Haichao-Z/doufu.github.io/PCBA/Good Night-(src,fab,asm)/ASM-Good Night-[NO VARIATIONS]-A.5/BOM/Bill of Materials-BillOfMaterials.xlsx

Name | Description | Designator | Footprint | LibRef | Quantity | Supplier Unit Price 1 | Supplier Subtotal 1 | Supplier Part Number 1 | Supplier 1 | Manufacturer Part Number 1 | Manufacturer Lifecycle 1 | Manufacturer 1 | Line #
CAP 0805 4.7UF 50V 10% X5R | Capacitor Surface Mount 0805 Footprint 4.7UF 50V 10% Tolerance Ceramic X5R | C1, C7, C9 | 0805_CAP | CMP-001-00021-2 | 3 | 0.35 | 1.05 | 311-1885-1-ND | Digikey | CC0805KKX7R8BB475 | Volume Production | Yageo
CAP 0603 0.01UF 50V 10% X7R | Capacitor Surface Mount 0603 Footprint 0.01UF 50V 10% Tolerance Ceramic X7R | C2 | 0603_CAP | CMP-011-000188-2 | 1 | 0.1 | 0.1 | 311-1085-6-ND | Digikey | CC0603KRX7R9BB103 | Volume Production | Yageo
CAP 0805 4.7UF 10V 10% X7R | Capacitor Surface Mount 0805 Footprint 4.7UF 10V 10% Tolerance Ceramic X7R | C3 | 0805_CAP | CMP-011-000522-1 | 1 | 0.35 | 0.35 | 311-1883-1-ND | Digikey | CC0805KKX7R7BB475 | Volume Production | Yageo
CAP 0603 0.1UF 50V 10% X7R | Capacitor Surface Mount 0603 Footprint 0.1UF 50V 10% Tolerance Ceramic X7R 100nF | C4, C5, C6, C32 | 0603_CAP | CMP-011-000223-3 | 4 | 0.024 | 0.24 | 311-1344-1-ND | Digikey | CC0603KRX7R9BB104 | Volume Production | Yageo
CAP 0603 1UF 50V 10% X7R | Capacitor Surface Mount 0603 Footprint 1UF 50V 10% Tolerance Ceramic X7R | C8, C11, C12, C28, C30, C34 | 0603_CAP | CMP-011-000287-2 | 6 | 0.052 | 0.52 | 311-1445-1-ND | Digikey | CC0603KRX5R8BB105 | Volume Production | Yageo
CAP 1206 10UF 50V 10% X5R | Capacitor Surface Mount 1206 Footprint 10UF 25V 10% Tolerance Ceramic X5R | C10, C13 | 1206_CAP | CMP-001-00003-5 | 2 | 0.15 | 0.3 | 311-1817-1-ND | Digikey | CC0603MRX5R6BB106 | Volume Production | Yageo
CAP 0603 18PF 50V 5% C0G | Capacitor Surface Mount 0603 Footprint 18PF 50V 5% Tolerance Ceramic C0G | C14, C15 | 0603_CAP | CMP-011-000283-1 | 2 | 0.1 | 0.2 | 311-1061-6-ND | Digikey | CC0603JRNPO9BN180 | Volume Production | Yageo
CAP 0603 10UF 16V 20% X5R | Capacitor Surface Mount 0603 Footprint 10UF 16V 20% Tolerance Ceramic X5R | C16, C26, C29 | 0603_CAP | CMP-011-000263-1 | 3 | 0.15 | 0.45 | 311-1817-1-ND | Digikey | CC0603MRX5R6BB106 | Volume Production | Yageo
C0805C476M9PACTU | CAP CER 47UF 6.3V X5R 0805 | C17, C24, C25 | FP-C0805C476M9PACTU-MFG | CMP-2007-01008-2 | 3 | 0.36 | 1.08 | 311-1897-1-ND | Digikey | CC0805MKX5R5BB476 | Volume Production | Yageo
CC0603KRX7R7BB104 | CAP CER 0.1UF 16V X7R 0603 | C18, C35, C37 | FP-CC0603-DA-MFG | CMP-2000-05002-2 | 3 | 0.1 | 0.3 | 13-CC0603KPX7R9BB101CT-ND | Digikey | CC0603KPX7R9BB101 | Volume Production | Yageo
CGA3E2X7R1H104K080AA | Cap Ceramic 100nF 50V X7R 10% Pad SMD 0603 +125°C Automotive T/R | C19 | FP-CGA3E-0_3-0_1-IPC_A | CMP-2000-07546-2 | 1 | 0.08 | 0.08 | 311-1088-6-ND | Digikey | CC0603KRX7R7BB104 | Volume Production | Yageo
C0603C105K3RACTU |  | C20 | CAPC1608X87X35LL15T15 | CMP-2006-03713-1 | 1 | 0.11 | 0.11 | 311-1456-1-ND | Digikey | CC0805KKX7R8BB105 | Volume Production | Yageo
C0805C822J2GACAUTO | CAP CER 8200PF 200V C0G/NP0 0805 | C21 | FP-C0805C-DN-MFG | CMP-2007-03316-2 | 1 | 0.1 | 0.1 | 311-4024-1-ND | Digikey | CC0603JRX7R9BB822 | Volume Production | Yageo
C0603C430J5GACTU | CAP CER 43PF 50V 5% NP0 0603 | C22 | FP-C0603C-CF-MFG | CMP-1035-01031-3 | 1 | 0.16 | 0.16 | 13-CC0603FRNPO9BN430CT-ND | Digikey | CC0603FRNPO9BN430 | Unknown | Yageo
06035C102KAT2A | General Purpose Ceramic Capacitor, 0603, 1nF, 10%, X7R, 15%, 50V | C23 | FP-0603-L_1_6_0_15-W_0_81-IPC_A | CMP-2006-04378-2 | 1 | 0.1 | 0.1 | 311-1127-1-ND | Digikey | CC0805KRX7R9BB102 | Volume Production | Yageo
CAP 0805 22UF 10V 20% X5R | Capacitor Surface Mount 0805 Footprint 22UF 10V 20% Tolerance Ceramic X5R | C27, C31, C33 | 0805_CAP_60H | CMP-011-000507-1 | 3 | 0.33 | 0.99 | 311-1900-1-ND | Digikey | CC0805MKX5R6BB226 | Volume Production | Yageo
EEUFR1H101 | Aluminum Electrolytic Capacitors (Radial Lead Type) 100uF ±20% 50V | C36, C38 | FP-RAD-TH-D_8_0_5-L_11_5-MFG | CMP-05427-002079-1 | 2 | 0.51 | 1.02 | 667-EEU-FR1H101 | Mouser | EEU-FR1H101 | Volume Production | Panasonic
LSM0805412V | Single Color LED, RED, 0805 | D1, D2 | LED_0805_RED | CMP-00026-00001-2 | 2 | 0.43 | 0.86 | 28-LSM0805412VCT-ND | Digikey | LSM0805412V | Volume Production | Visual Communications
LSM0805452V | Single Color LED, Green, 0805 | D3, D6, D12 | LED_0805 | CMP-00038-4 | 3 | 0.34 | 1.02 | 28-LSM0805452VCT-ND | Digikey | LSM0805452V | Volume Production | Visual Communications
SMBJ5.0CA-TR | TVS DIODE 5V 13.4V SMB | D13 | FP-SMB-CA-MFG | CMP-12225-000020-1 | 1 | 0.47 | 0.47 | 497-3145-1-ND | Digikey | SMBJ5.0CA-TR | Volume Production | STMicroelectronics
LSM0805543V | LED Uni-Color Blue 469nm Automotive 2-Pin Chip 0805(2012Metric) T/R | D14 | LED_0805_WHITE | CMP-00535-1 | 1 | 0.59 | 0.59 | 28-LSM0805543VCT-ND | Digikey | LSM0805543V | Volume Production | Visual Communications
LSM0805463V | LED Uni-Color Blue 469nm Automotive 2-Pin Chip 0805(2012Metric) T/R | D15 | LED_0805_BLUE | CMP-00457-1 | 1 | 0.43 | 0.43 | 28-LSM0805463VCT-ND | Digikey | LSM0805463V | Volume Production | Visual Communications
LSM0805472V | LED Uni-Color Yellow 590nm Automotive 2-Pin Chip 0805(2012Metric) T/R | D16 | LED_0805_YELLOW | CMP-031-000001-1 | 1 | 0.34 | 0.34 | 28-LSM0805472VCT-ND | Digikey | LSM0805472V | Volume Production | Visual Communications
ECLAMP2410PQTCT | Trans Voltage Suppressor Diode, 5V V(RWM), Bidirectional, 7 Element, Silicon with EMI Filter | DN1 | ECLAMP2410PQTCT-Footprint-1 | CMP-00096-2 | 1 | 2.07 | 2.07 | ECLAMP2410PQTCTCT-ND | Digikey | ECLAMP2410PQTCT | Volume Production | Semtech
MF-NSMF050-2 | PTC RESET FUSE 13.2V 500MA 1206 | F1, F2 | FP-MF-NSMF050-2-MFG | CMP-07400-000036-1 | 2 | 0.19 | 0.38 | MF-NSMF050-2CT-ND | Digikey | MF-NSMF050-2 | Volume Production | Bourns
MPZ2012S601AT000 | 600 Ohms @ 100 MHz 1 Power Line Ferrite Bead 0805 (2012 Metric) 2A 100mOhm | FB1 | FP-MPZ2012-MFG (0805) | CMP-00563-1 | 1 | 0.11 | 0.11 | 445-MPZ2012S601AT000CT-ND | Digikey | MPZ2012S601AT000 | Volume Production | TDK
USBUF02W6 | Terminator, 2-Line, PDSO6; RC (Pi) EMI Filter 2nd Order Low Pass 2 Channel R = 22Ohms, C = 47pF 6-TSSOP, SC-88, SOT-363, USB 1.1 | FL1 | SOT-363-6-ST | CMP-00571-2 | 1 | 0.32 | 0.32 | 497-3743-1-ND | Digikey | USBUF02W6 | Volume Production | STMicroelectronics
693071020811 | WR-CRD Micro SD Card Connector Push & Push | J1 | 693071020811 | CMP-00419-6 | 1 | 3.56 | 3.56 | 732-693071020811CT-ND | Digikey | 693071020811 | Volume Production | Wurth Electronics
ARM Cortex Debug | 10 Pin Shrouded Header, 0.050", Key Pin 7 | J2 | FTSH-105-01-F-DV-007-K PLUGIN | CMP-002-000013-2 | 1 | 2.27 | 2.27 | SAM11250-ND | Digikey | FTSH-105-01-F-DV-007-K-P | Volume Production | Samtec
MHDR 1X2 | Header, 2-Pin, 0.1in Pitch, Male | J4, J5, J6, J7, J8, J9, J10, J11, J12, J13 | PH1-02-UA | CMP-000021-1 | 10
MHDR 1X3 | Header, 3-Pin, 0.1in Pitch, Male | J14, J15 | PH1-03-UA WITH CONNECTOR | CMP-000023-1 | 2
MHDR 1X7 | Header, 7-Pin, 0.1in Pitch, Male | J16 | MHDR 1X7-Footprint-1 | CMP-00373-1 | 1 | 0.1 | 0.1 | 2057-PH1-07-UA-ND | Digikey | PH1-07-UA | Unknown | Adam Equipment
B2B-PH-SM4-TBT(LF)(SN) | Connector Header, PH Series, 2 Position, 2.00mm, 100V, Surface Mount, Solder, Pick and Place, Natural. | J32 | FP-B2B-PH-SM4-TBT_LF_SN-MFG | CMP-00418-1 | 1 | 0.69 | 0.69 | 455-B2B-PH-SM4-TBTDKR-ND | Digikey | B2B-PH-SM4-TBT | Unknown | JST
USB4110-GF-A | USB Connector, 16 Contact(s), Male, Right Angle, Surface Mount Terminal, Locking, Receptacle USB-C (USB TYPE-C) USB 2.0 Receptacle Connector 24 (16+8 Dummy) Position Surface Mount, Right Angle | J33 | FP-USB4110-GF-A-MFG | CMP-00451-3 | 1 | 1.24 | 1.24 | 2073-USB4110-GF-A-6-ND | Digikey | USB4110-GF-A | Volume Production | Global Connector Technology
0603 link | 0O link, SMD, 0603, Solder Bridge Option | JP1, JP2, JP4, JP5, JP9, JP10, JP11, JP12, JP13, JP14 | 0603_JP_RES | CMP-00422-5 | 10 | 0.01 | 0.1 | RMCF0603ZT0R00CT-ND | Digikey | RMCF0603ZT0R00 | Volume Production | Stackpole Electronics
744373360047 | General Purpose Inductor, 0.47uH, 20%, 1 Element, Powdered Iron-Core, SMD, 2220 | L1 | WE-LHMI_5030 | CMP-002-000030-2 | 1 | 2.45 | 2.45 | 732-6160-1-ND | Digikey | 744373360047 | Volume Production | Wurth Electronics
LQW21HN1R0J00L | FIXED IND 1UH 115MA 2.86 OHM SMD | L2 | FP-LQW21HN_00-MFG | CMP-06042-000167-1 | 1 | 0.34 | 0.34 | 490-9679-1-ND | Digikey | LQW21HN1R0J00L | Volume Production | Murata
744311100 | General Purpose Inductor, 1uH, 20%, 1 Element, SMD, 2827 | L3 | WE-HCI_7040 | CMP-002-000018-2 | 1 | 3.42 | 3.42 | 732-4177-1-ND | Digikey | 744311100 | Volume Production | Wurth Electronics
RES 0603 1K 1% | Resistor Surface Mount, 1K Ohms, 0603 Footprint, 1% Tolerance 0.1W | R1, R3, R4, R6, R7 | 0603_RES | CMP-005-002503-3 | 5 | 0.02 | 0.2 | RMCF0603FT1K00CT-ND | Digikey | RMCF0603FT1K00 | Volume Production | Stackpole Electronics
RES 0603 1.13K 1% | Resistor Surface Mount, 1.13K Ohms, 0603 Footprint, 1% Tolerance 0.1W | R2, R5 | 0603_RES | CMP-005-001984-2 | 2 | 0.1 | 0.2 | RMCF0603FT1K13CT-ND | Digikey | RMCF0603FT1K13 | Volume Production | Stackpole Electronics
RES 0603 100 1% | Resistor Surface Mount, 100 Ohms, 0603 Footprint, 1% Tolerance 0.1W | R8, R9, R39 | 0603_RES | CMP-005-002125-2 | 3 | 0.02 | 0.2 | RMCF0603FT100RDKR-ND | Digikey | RMCF0603FT100R | Volume Production | Stackpole Electronics
RES 0603 10K 1% | Resistor Surface Mount, 10K Ohms, 0603 Footprint, 1% Tolerance 0.1W | R10, R11 | 0603_RES | CMP-005-002156-3 | 2 | 0.1 | 0.2 | RMCF0603FT10K0DKR-ND | Digikey | RMCF0603FT10K0 | Volume Production | Stackpole Electronics
RES 0603 12K 5% | Resistor Surface Mount, 12K Ohms, 0603 Footprint, 5% Tolerance 0.1W | R12 | 0603_RES | CMP-005-002260-2 | 1 | 0.1 | 0.1 | RMCF0603FT12K0DKR-ND | Digikey | RMCF0603FT12K0 | Volume Production | Stackpole Electronics
RES 0603 5.1K 1% | Resistor Surface Mount, 5.1K Ohms, 0603 Footprint, 1% Tolerance 0.1W | R13, R15 | 0603_RES | CMP-005-003296-4 | 2 | 0.019 | 0.19 | RMCF0603JT5K10CT-ND | Digikey | RMCF0603JT5K10 | Volume Production | Stackpole Electronics
RES 0603 10K 0.1% | Resistor Surface Mount, 10K Ohms, 0603 Footprint, 0.1% Tolerance 0.1W | R14, R34 | 0603_RES | CMP-005-002155-2 | 2 | 0.1 | 0.2 | RMCF0603FT10K0DKR-ND | Digikey | RMCF0603FT10K0 | Volume Production | Stackpole Electronics
RES 0603 0 5% | Resistor Surface Mount, 0 Ohms, 0603 Footprint, 5% Tolerance 0.1W | R16, R17, R19, R20, R24, R35 | 0603_RES | CMP-005-001964-4 | 6 | 0.01 | 0.1 | RMCF0603ZT0R00CT-ND | Digikey | RMCF0603ZT0R00 | Volume Production | Stackpole Electronics
RES 0603 4.7K 1% | Resistor Surface Mount, 4.7K Ohms, 0603 Footprint, 1% Tolerance 0.1W | R21, R23 | 0603_RES | CMP-005-003137-2 | 2 | 0.1 | 0.2 | RMCF0603FT4K70CT-ND | Digikey | RMCF0603FT4K70 | Volume Production | Stackpole Electronics
RES 0805 470 5% | Resistor Surface Mount, 470 Ohms, 0805 Footprint, 5% Tolerance 0.125W | R22, R36, R37, R38 | 0805_RES | CMP-005-005144-2 | 4 | 0.022 | 0.22 | RMCF0805JT470RCT-ND | Digikey | RMCF0805JT470R | Volume Production | Stackpole Electronics
RP73D2A267KBTDF | Surface Mount Resistors, Precision Resistor, 2 Terminations, Size Code 0805, Cut Tape Length, .1%, Thin Film, 10K 0.1% 10PPM | R25 | FP-RP732A-MFG | CMP-03211-008573-2 | 1 | 0.1 | 0.1 | RMCF0805FT267KCT-ND | Digikey | RMCF0805FT267K | Volume Production | Stackpole Electronics
CRCW0805127KFKEA | RES Thick Film, 127kΩ, 1%, 0.125W, 100ppm/°C, 0805 | R26 | FP-CRCW0805-e3-MFG | CMP-2001-04290-2 | 1 | 0.1 | 0.1 | RMCF0805FT127KCT-ND | Digikey | RMCF0805FT127K | Volume Production | Stackpole Electronics
CRGCQ0805J470K | CRGCQ0805 470KΩ 0.125W ±100ppm/°C 5% 150V | R27 | FP-CRGCQ0805-IPC_C | CMP-03211-004111-1 | 1 | 0.1 | 0.1 | RMCF0805JT470KCT-ND | Digikey | RMCF0805JT470K | Volume Production | Stackpole Electronics
CRCW060328K7FKEA |  | R28 | RESC1609X50X30NL10T20 | CMP-2000-03154-1 | 1 | 0.1 | 0.1 | RMCF0603FT28K7CT-ND | Digikey | RMCF0603FT28K7 | Volume Production | Stackpole Electronics
ERJ-6ENF1183V |  | R29 | RESC2013X70X40NL20T20 | CMP-2001-04400-1 | 1 | 0.1 | 0.1 | RMCF0805FT118KCT-ND | Digikey | RMCF0805FT118K | Volume Production | Stackpole Electronics
RES 0805 100K 1% | Resistor Surface Mount, 100K Ohms, 0805 Footprint, 1% Tolerance 0.125W | R30 | 0805_RES | CMP-005-004027-2 | 1 | 0.1 | 0.1 | RMCF0805FG100KCT-ND | Digikey | RMCF0805FG100K | Volume Production | Stackpole Electronics
RES 0805 732K 1% | Resistor Surface Mount, 732K Ohms, 0805 Footprint, 1% Tolerance 0.125W | R31 | 0805_RES | CMP-005-005525-2 | 1 | 0.1 | 0.1 | 738-RMCF0805FT732KCT-ND | Digikey | RMCF0805FT732K | Volume Production | Stackpole Electronics
RES 0603 2K 0.1% | Resistor Surface Mount, 2K Ohms, 0603 Footprint, 0.1% Tolerance 0.1W | R33 | 0603_RES | CMP-005-002832-2 | 1 | 0.1 | 0.1 | RMCF0603FT2K00DKR-ND | Digikey | RMCF0603FT2K00 | Volume Production | Stackpole Electronics
RC0603FR-071ML | Chip Resistor, 1 MOhm, +/- 1%, 100 mW, -55 to 155 degC, 0603 (1608 Metric), RoHS, Tape and Reel | R40 | RESC1608X55X25LL10T15 | CMP-1659-00056-1 | 1 | 0.1 | 0.1 | RMCF0603FG1M00CT-ND | Digikey | RMCF0603FG1M00 | Volume Production | Stackpole Electronics
PTS810SJK250SMTRLFS | Keypad Switch, 1 Switches, SPST, Momentary tactile button, 0.05A, 16VDC, 3.23N, Solder Terminal, Surface Mount-straight | SW1, SW2, SW7 | PTS810SJK250SMTRLFS-Footprint-1 | CMP-00084-6 | 3 | 0.49 | 1.47 | CKN10503CT-ND | Digikey | PTS810SJK250SMTRLFS | Volume Production | ITT C&K
JS202011JCQN | Slide Switch, 2 Positions, DPDT, Latched, 0.3A, 6VDC, Solder Terminal, Surface Mount-straight | SW6 | FP-JS202011JCQN-MFG | CMP-00536-1 | 1 | 0.81 | 0.81 | CKN10723CT-ND | Digikey | JS202011JCQN | Volume Production | ITT C&K
5281 | Circuit Board Hardware - PCB TEST POINT BLACK MULTIPURPOSE 5011 5281 | TP8 | KSTN-5011_V | CMP-024-000010-2 | 1 | 0.22 | 0.22 | 534-5281 | Mouser | 5281 | Unknown | Keystone Electronics
FT234XD-R | USB Bridge, USB to UART USB 2.0 UART Interface 12-DFN (3x3) | U1 | FP-DFN-12-MFG | CMP-00104-3 | 1 | 2.26 | 2.26 | 768-1178-6-ND | Digikey | FT234XD-R | Volume Production | FTDI
BQ24075RGTR | Power Supply Support Circuit, Adjustable, 1 Channel, 6.6, PQCC16 | U2 | FP-RGT0016C-IPC_A | CMP-00080-5 | 1 | 2.13 | 2.13 | 296-38874-1-ND | Digikey | BQ24075RGTR | Volume Production | Texas Instruments
ATSAMW25H18-MR210 | WiFi 802.11b/g/n Transceiver Module 2.412GHz ~ 2.484GHz Integrated, Trace Surface Mount, Integrated SAMD21 Cortex M0+ | U3 | ATSAMW25H18-MR210-Footprint-1 | CMP-00071-11 | 1 | 15.3 | 15.3 | ATSAMW25H18-MR210PB1954 | microchipDIRECT | ATSAMW25H18-MR210PB1954 | Volume Production | Microchip
TPS62086RLTR | IC REG BUCK 3.3V 3A 7VSON-HR | U4 | FP-RLT0007A-MFG | CMP-04918-000186-1 | 1 | 1.58 | 1.58 | 296-40831-1-ND | Digikey | TPS62086RLTR | Volume Production | Texas Instruments
TPS61088RHLT | Switching Regulator, Current-mode, 13A, 2200kHz Switching Freq-Max, PQCC20 | U5 | FP-RHL0020A-MFG | CMP-00676-1 | 1 | 5.21 | 5.21 | 296-42129-1-ND | Digikey | TPS61088RHLT | Volume Production | Texas Instruments
TPS61022RWUR | POWER MANAGEMENT | U6 | FP-RWU0007A-MFG | CMP-04918-000029-1 | 1 | 1.67 | 1.67 | 296-TPS61022RWURCT-ND | Digikey | TPS61022RWUR | Volume Production | Texas Instruments
vc-02 | AI Audio Module | U7 | SON180P1700X265-20N | CMP-00713-2 | 1 | 3.95 | 3.95 | 4570-VC-02CT-ND | Digikey | VC-02 | Unknown | Ai-Thinker
ABS07-32.768KHZ-T | Parallel - Fundamental Quartz Crystal, 0.032768MHz Nom | Y1 | FP-ABS07-MFG | CMP-078-000002-2 | 1 | 0.61 | 0.61 | 535-9542-6-ND | Digikey | ABS07-32.768KHZ-T | Volume Production | Abracon
