Haichao-Z/doufu.github.io/3D_Model/battery_cage.SLDPRT

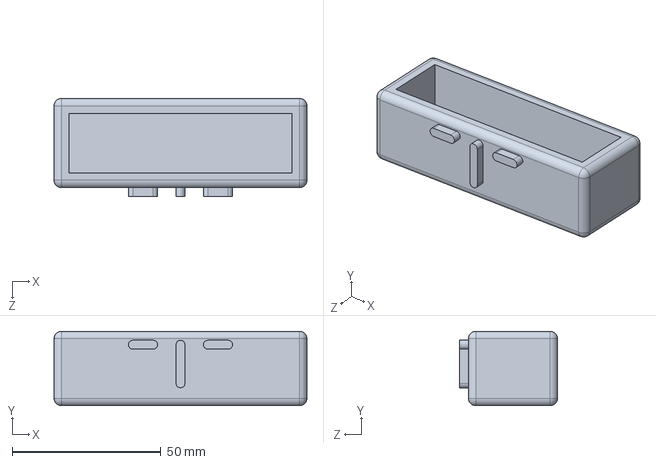
[picture p19: CAD file, 2025-04-30]
3D_Model/battery_cage.SLDPRT
85.0 x 25.0 x 33.0 mm
