Haichao-Z/doufu.github.io/3D_Model/LCD_base.SLDPRT

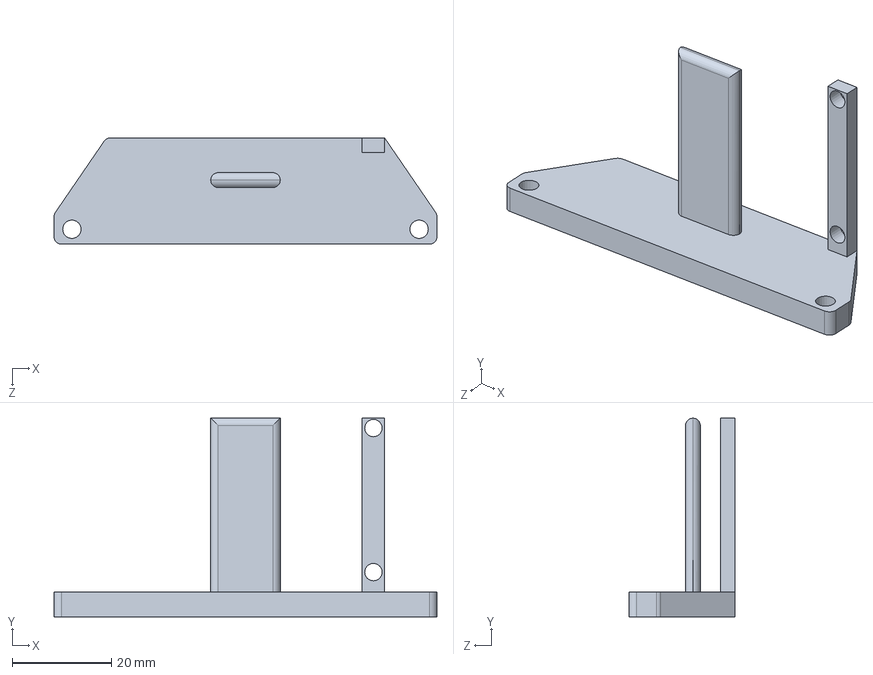
[picture p20: CAD file, 2025-04-30]
3D_Model/LCD_base.SLDPRT
77.1 x 40.0 x 21.4 mm
