Haichao-Z/doufu.github.io/3D_Model/base.SLDPRT

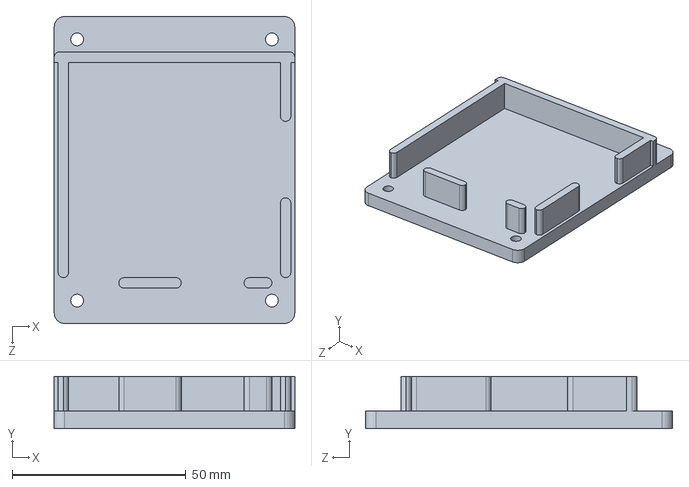
[picture p21: CAD file, 2025-04-30]
3D_Model/base.SLDPRT
69.3 x 15.0 x 88.4 mm
