Haichao-Z/doufu.github.io/(list of files, cad)

Other CAD files:
3D_Model/LCD_base.STL
3D_Model/base.STL
3D_Model/battery_cage.STL
