Haichao-Z/doufu.github.io/(list of files, drawings)

Other design files:
PCBA/Good Night-(src,fab,asm)/SRC-Good Night-A.5/AI_Audio_Module.SchDoc
PCBA/Good Night-(src,fab,asm)/SRC-Good Night-A.5/BatteryCharger.SchDoc
PCBA/Good Night-(src,fab,asm)/SRC-Good Night-A.5/Boost_5V.SchDoc
PCBA/Good Night-(src,fab,asm)/SRC-Good Night-A.5/Boost_6V.SchDoc
PCBA/Good Night-(src,fab,asm)/SRC-Good Night-A.5/Buck_3V3.SchDoc
PCBA/Good Night-(src,fab,asm)/SRC-Good Night-A.5/Good Night.PrjPcb
PCBA/Good Night-(src,fab,asm)/SRC-Good Night-A.5/LED Strip.SchDoc
PCBA/Good Night-(src,fab,asm)/SRC-Good Night-A.5/MCU.SchDoc
PCBA/Good Night-(src,fab,asm)/SRC-Good Night-A.5/Memory.SchDoc
PCBA/Good Night-(src,fab,asm)/SRC-Good Night-A.5/Motor.SchDoc
PCBA/Good Night-(src,fab,asm)/SRC-Good Night-A.5/OLED.SchDoc
PCBA/Good Night-(src,fab,asm)/SRC-Good Night-A.5/PCB_V1.PcbDoc
PCBA/Good Night-(src,fab,asm)/SRC-Good Night-A.5/SerialToUSB.SchDoc
PCBA/Good Night-(src,fab,asm)/SRC-Good Night-A.5/Top Level.SchDoc
PCBA/Good Night/AI_Audio_Module.SchDoc
PCBA/Good Night/BatteryCharger.SchDoc
PCBA/Good Night/Boost_5V.SchDoc
PCBA/Good Night/Boost_6V.SchDoc
PCBA/Good Night/Buck_3V3.SchDoc
PCBA/Good Night/CommonComponents.SchDoc
PCBA/Good Night/Good Night.PrjPcb
PCBA/Good Night/LED Strip.SchDoc
PCBA/Good Night/MCU.SchDoc
PCBA/Good Night/Memory.SchDoc
PCBA/Good Night/Microphone and Speaker.SchDoc
PCBA/Good Night/Motor.SchDoc
PCBA/Good Night/OLED.SchDoc
PCBA/Good Night/PCB_V1.PcbDoc
PCBA/Good Night/SerialToUSB.SchDoc
PCBA/Good Night/Top Level.SchDoc
PCBA/Good Night/VC_02_AI.SchDoc
