Haichao-Z/doufu.github.io/(commit log)

2025-04-30 clone original date into new repo
    [LCD_base.SLDPRT, LCD_base.STL, base.SLDPRT, base.STL, battery_cage.SLDPRT, battery_cage.STL]
2025-05-01 PCBA update
    [AI_Audio_Module.SchDoc, BatteryCharger.SchDoc, Bill of Materials-BillOfMaterials(Prototype Variant).xlsx, Bill of Materials-BillOfMaterials(Unpopulated).xlsx, Bill of Materials-BillOfMaterials.xlsx, Boost_5V.SchDoc, Boost_6V.SchDoc, Buck_3V3.SchDoc]
2025-05-01 PCBA readme update
