Haichao-Z/doufu.github.io/(notices)

Notices in the files:
Application/src/IMU/lsm6dso_reg.c:
(C) COPYRIGHT STMicroelectronics *****END OF FILE
