Haichao-Z/doufu.github.io/Images/PCB_top.png

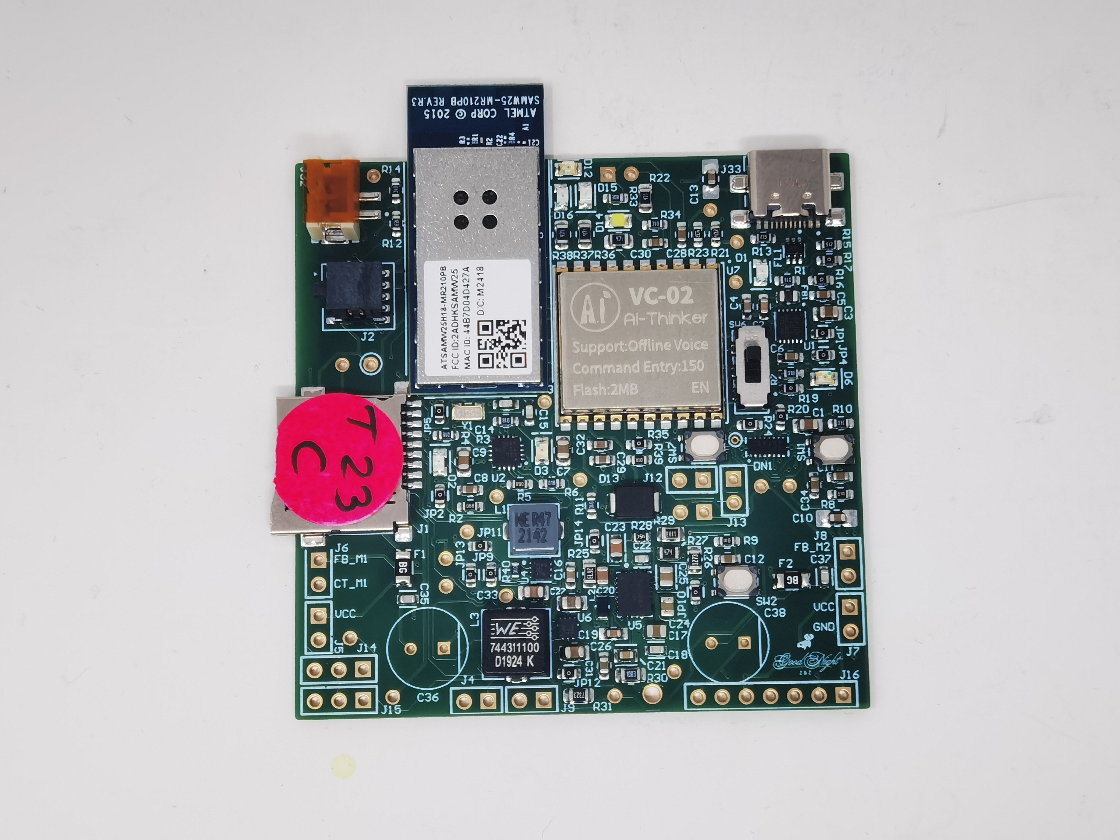
[picture p11: Images/PCB_top.png]
Images/PCB_top.png
